laminarize/Chistmas-TrESP32/hardware/board_3d_render.png

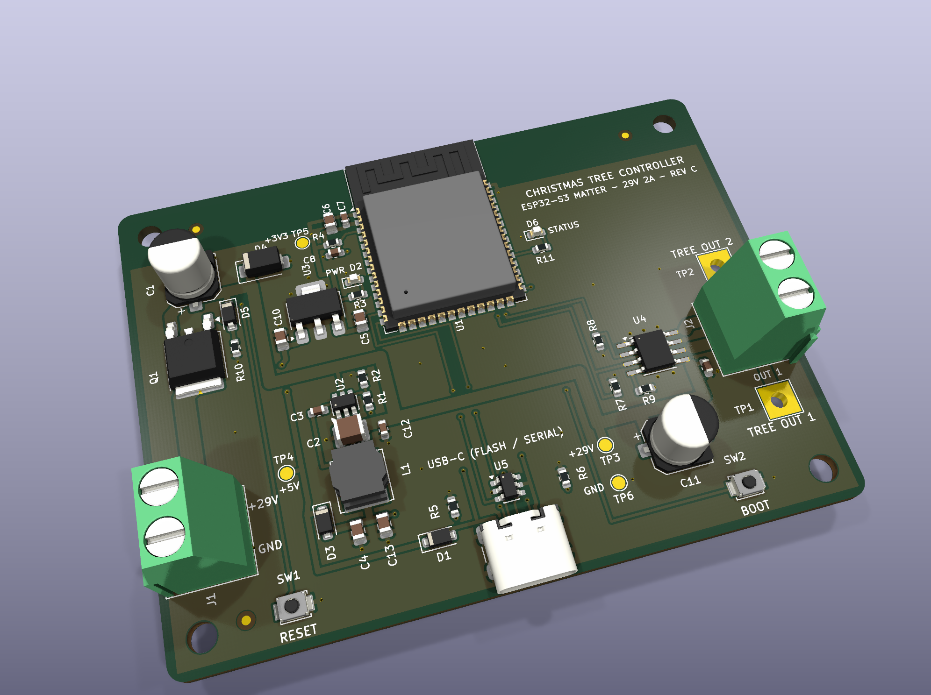
hardware/board_3d_render.png
