laminarize/Chistmas-TrESP32/README.md

# Christmas TrESP32 — SmartThings Matter Christmas Tree Controller

**Manufacturer:** `Pixel Paw Studio`  
**Model:** `Christmas TrESP32`

A high-performance DIY replacement for the stock 29V DC power supply and inline foot-pedal receiver controller (e.g., **Ting Shen `TS-48W29V`** `29V DC, 1.66A, 48W` brick + **`FPTSR-053-29-20`** inline button receiver + **Polygroup `PDT-015-14`** RF remote on the Home Decorators Collection `25PG90091` 9 ft. Yorkshire Twinkling Fir and similar 2-wire bi-color trees).

Built using **ESP-IDF** and the official **`esp-matter`** SDK on an **ESP32-S3**, this controller pairs natively with **Samsung SmartThings** over local Wi-Fi via **Matter** on **1 single endpoint** and includes a **custom local SmartThings Lua Edge Driver ([`edge-driver/`](edge-driver/))** that places **Master Power**, **Ultrasonic Dimmer (`25 kHz` PWM)**, and a clean **RGB Multicolor On/Off Toggle Switch** onto **1 single SmartThings app entry** (with zero rainbow color wheels or extra room tiles).

---

## 1. Hardware Options: Custom Rev C PCB vs. Breakout Modules

You can build this controller either using our **turnkey single-board custom PCB (`hardware/`, Rev C)** or on a breadboard/enclosure using off-the-shelf breakout modules.

### Option 1: Custom Single-Board Controller PCB (`hardware/`, Rev C — Recommended)

The [`hardware/`](hardware/) directory contains a complete KiCad 9/10 hardware design and ready-to-order **JLCPCB** and **PCBWay** fabrication + turnkey PCBA files (`80 × 60 mm`, 2-layer, `1 oz` copper, minimum drill `0.30 mm`):

- **Integrated Single-Plug Power & Logic:** Steps down the `29V DC` tree power brick via a TI **`LMR51430XDDCR`** (`36V, 3A` synchronous buck $\to 5.21\text{ V}$) and low-dropout `3.3V, 1A` regulator (`U3`: `AP7361C-33E-13` / `MCP1826S-3302E/DB`) to power an onboard **`ESP32-S3-WROOM-1-N8`** (`U1`) and TI **`DRV8871DDA`** H-bridge (`U4`, `R9 = 36 kΩ` $\to 1.78\text{ A}$ current limit, solid-poured thermal pad with tented vias).
- **Full Input & Host Computer USB Protection:**
  - **Zero-Drop Reverse-Polarity & Surge Protection:** **`AOD4185`** `40V` P-MOSFET (`Q1`) + `12V` gate Zener (`D5`) + **`SMAJ30A`** TVS clamp (`D4`), paired with the `29V 2A` Class 2 power supply's built-in hiccup OCP and `DRV8871`'s `1.78A` active cycle-by-cycle current limit.
  - **Computer-Safe Dual-Supply OR-ing (`D1`, `D3`) & USB ESD (`U5`):** Automotive-qualified (`AEC-Q101`) Nexperia **`PMEG4010CEH,115`** low-leakage `40V, 1A` MEGA Schottky diodes in flat-lead `SOD-123F` isolate `USB-C VBUS` (`J3`, protected by `USBLC6-2SC6`) from `+5V_BUCK` so plugging in a laptop while `29V DC` is live can never back-feed `VBUS`.
- **Flexible Tree Wiring & Onboard Diagnostics:**
  - **`J1` (`29V_DC_IN`):** `5.08 mm` Phoenix Contact (`1729128`) screw terminal for the `29V 2A` power brick.
  - **`J2` (`TREE_29V_OUT`) + `TP1`/`TP2`:** Connect the 2-wire tree cable either via the `5.08 mm` screw terminal (`J2`) or directly to the `4 × 4 mm` (`2.0 mm` plated hole) strain-relief solder pads (`TP1`/`TP2`).
  - **Onboard Controls, LEDs & Probe Pads:** `SW1` (`RESET`), `SW2` (`BOOT` / `GPIO 0`), `D2` (`3.3V` red power LED), `D6` (`GPIO 38` green Matter status LED), and `1.5 mm` SMD diagnostic probe pads `TP3` (`+29V`), `TP4` (`+5V`), `TP5` (`+3V3`), and `TP6` (`GND`).
- **Ordering Files (`hardware/`):**
  - **Bare PCB Fabrication (JLCPCB or PCBWay):** Upload [`hardware/gerbers.zip`](hardware/gerbers.zip).
  - **JLCPCB Turnkey PCBA:** Upload [`hardware/jlcpcb_bom.csv`](hardware/jlcpcb_bom.csv) (`42` populated parts across `28` verified in-stock LCSC `Cxxxxxx` lines, with `11` Basic/Preferred lines for free feeder setup) and [`hardware/jlcpcb_positions.csv`](hardware/jlcpcb_positions.csv) (`42` CPL placements with EasyEDA pad/polarity rotation & midpoint offsets).
  - **PCBWay Turnkey PCBA:** Upload [`hardware/bom.csv`](hardware/bom.csv) (`42` populated parts across `29` unique MPN lines) and [`hardware/positions.csv`](hardware/positions.csv) (`42` native KiCad IPC-7351B placements).

| Custom Rev C PCB Signal | ESP32-S3 Pin | Connected Hardware |
| :--- | :--- | :--- |
| **`TREE_IN1` (Warm White PWM)** | `GPIO 5` (`U1` Pin 5) | `DRV8871DDA` `IN1` (`25 kHz` PWM + `100 kΩ` pull-down `R7`) |
| **`TREE_IN2` (RGB Multicolor PWM)** | `GPIO 6` (`U1` Pin 6) | `DRV8871DDA` `IN2` (`25 kHz` PWM + `100 kΩ` pull-down `R8`) |
| **`BOOT` / Factory Reset Button** | `GPIO 0` (`U1` Pin 27) | `SW2` (`3 s` hold triggers Matter factory reset) |
| **`STATUS` LED (Matter State)** | `GPIO 38` (`U1` Pin 31) | `R11` (`1 kΩ`) + `D6` (`570 nm` green `0603` LED) |
| **Native USB-C Flash / Logs** | `GPIO 19` (`D-`), `GPIO 20` (`D+`) | `J3` (`USB4105-GF-A`) via `U5` (`USBLC6-2SC6`) |

---

### Option 2: Off-the-Shelf Breakout Bill of Materials (BOM)

| Component | Recommendation | Estimated Cost | Notes |
| :--- | :--- | :--- | :--- |
| **Microcontroller** | **ESP32-S3 DevKit** (8MB or 16MB Flash) | $5 – $9 | Dual-core Xtensa LX7, 2.4 GHz Wi-Fi + BLE 5.0 for Matter commissioning. |
| **H-Bridge Driver** | **Adafruit / TI DRV8871 Breakout Board** | $3 – $8 | Rated 6.5V – 45V DC @ 3.6A peak. Includes `POWER (+/-)` and `MOTOR` screw terminals plus `GND`, `VM`, `IN1`, `IN2` logic pins. Driven at `25 kHz` ultrasonic PWM for silent dimming. |
| **Power Supply (Tree LEDs)** | **Generic 29V 2A DC Power Supply** (Amazon) | $12 – $18 | Standard 29V DC / 2A (58W) replacement power brick for 29V LED Christmas trees. |
| **ESP32 Power** | **USB-C 5V Adapter** *or* **LM2596HV Buck Converter** | $0 – $4 | Power the ESP32-S3 directly via USB-C, or step down the 29V supply to 5.0V DC using an `LM2596HV` buck converter into `5V/VIN`. |

---

## 2. Electrical Wiring Diagram

Bypass the factory inline foot-pedal / RF receiver pod (e.g., **`FPTSR-053-29-20`**) downstream of the `29V` brick and connect the `DRV8871` output directly to the 2-wire tree string. The tree uses **anti-parallel LED strings** over its 2-wire bus:
- **Polarity A (`+29V` on `OUT1`, `GND` on `OUT2` — driven by `IN1` / `GPIO 5`):** Illuminates the **Warm White** LEDs (with built-in hardware twinkling on the secondary fairy bulbs).
- **Polarity B (`GND` on `OUT1`, `+29V` on `OUT2` — driven by `IN2` / `GPIO 6`):** Illuminates the **RGB Festive Multicolor** LEDs (with built-in hardware twinkling on the secondary fairy bulbs).
- **Motor Screw Terminal Polarity:** Because 2-wire bi-color trees wire Warm White and RGB LEDs in anti-parallel across the two wires, the `MOTOR` screw terminals are **non-polarized** with respect to safety—swapping the two tree wires simply swaps which polarity corresponds to Warm White vs. RGB Multicolor. *(Always bypass any inline factory foot-pedal/RF button pod first; leaving an inline receiver pod in series blocks reverse polarity.)*

### Option A: Powering ESP32-S3 via USB-C (Recommended & Simplest)

```
                      [ 120V AC Wall Plug ]
                                │
                                ▼
                     ┌─────────────────────┐
                     │ Generic 29V 2A PSU  │
                     │ Output: 29V DC 2.0A │
                     └───────┬─────┬───────┘
                    +29V DC  │     │  -29V (GND)
                             ▼     ▼
                  ┌───────────────────────────┐
   [ 5V USB-C ]   │  DRV8871 Breakout Board   │
        │         │                           │
        ▼         │  Screw Terminals:         │
┌───────────────┐ │   POWER + <── +29V DC     │
│ ESP32-S3      │ │   POWER - <── -29V (GND)  │
│               │ │   MOTOR 1 ────────────────┼───> Tree Wire +
│  GPIO 5 (5~) ─┼─┼─> IN1                     │
│  GPIO 6 (6~) ─┼─┼─> IN2     MOTOR 2 ────────┼───> Tree Wire -
│  GND ─────────┼─┼─> GND                     │
└───────────────┘ │  (VM pin is internally    │
                  │   tied to POWER +)        │
                  └───────────────────────────┘
```

### Option B: Single-Plug Power via LM2596HV Buck Converter (29V $\to$ 5.0V)

```
                      [ 120V AC Wall Plug ]
                                │
                                ▼
                     ┌─────────────────────┐
                     │ Generic 29V 2A PSU  │
                     │ Output: 29V DC 2.0A │
                     └──────────┬──────────┘
                                │  +29V DC & GND
                 ┌──────────────┴──────────────┐
                 │                             │
                 ▼                             ▼
      ┌────────────────────┐        ┌──────────────────────────┐
      │ LM2596HV Buck      │        │ DRV8871 Breakout Board   │
      │ IN+:  +29V DC      │        │ POWER + (VM): +29V DC    │
      │ IN-:  GND (Common) │        │ POWER - / GND: Common GND│
      │ OUT+: +5.0V DC     │        │ IN1: <── ESP32 GPIO 5    │
      │ OUT-: GND (Common) │        │ IN2: <── ESP32 GPIO 6    │
      └──────────┬─────────┘        │ MOTOR 1 ──┐              │
                 │ +5.0V            │ MOTOR 2 ──┼─┐            │
                 ▼                  └───────────┼─┼────────────┘
      ┌────────────────────┐                    │ │
      │ ESP32-S3 DevKit    │                    │ │
      │ 5V / VIN <── (+5V) │                    │ │
      │ GND      <── (GND) │                    │ │
      │ GPIO 5 (5~) ──> IN1│                    │ │
      │ GPIO 6 (6~) ──> IN2│                    │ │
      └────────────────────┘                    ▼ ▼
                                     ┌──────────────────────┐
                                     │ Tree 2-Pin Connector │
                                     │ Wire + : MOTOR 1     │
                                     │ Wire - : MOTOR 2     │
                                     └──────────────────────┘
```

### Pin Summary Table

| DRV8871 Pin / Terminal | Connected To | Purpose |
| :--- | :--- | :--- |
| **`POWER +`** (Screw Terminal) | `29V 2A PSU` **`+29V`** | High-voltage motor/LED supply (`29V DC`) |
| **`POWER -`** (Screw Terminal) | `29V 2A PSU` **`-` (`GND`)** | High-voltage return ground (internally tied to `GND` pin) |
| **`GND`** (Through-Hole Pin) | **ESP32-S3 `GND`** | Common logic ground reference between ESP32 and DRV8871 |
| **`VM`** (Through-Hole Pin) | *Leave unconnected* | Internally connected to `POWER +` on the breakout board |
| **`IN1`** (Through-Hole Pin) | **ESP32-S3 `GPIO 5` (`5~`)** | `25 kHz` PWM input for **Warm White** (`Polarity A`) |
| **`IN2`** (Through-Hole Pin) | **ESP32-S3 `GPIO 6` (`6~`)** | `25 kHz` PWM input for **RGB Multicolor** (`Polarity B`) |
| **`MOTOR`** (Screw Terminals) | **Tree `+` and `-` Cable** | Switched `29V` H-bridge output to the tree LED strings |

> [!CAUTION]
> **If using an LM2596HV Buck Converter:** Connect the 29V power supply to the buck converter inputs (`IN+` and `IN-`) **before** connecting the ESP32. Measure `OUT+` and `OUT-` with a multimeter and adjust the trim pot to **5.0V DC** before wiring `OUT+` to the ESP32 `5V/VIN` pin.

---

## 3. Single-Entry SmartThings UI & Local Edge Driver (`edge-driver/`)

`Christmas TrESP32` exposes **only 1 Matter Endpoint (`Endpoint 1`)** on the ESP32-S3 and ships with a local Lua Edge Driver ([`edge-driver/`](edge-driver/)) that runs directly on your SmartThings Hub over LAN, presenting **1 single device entry** in the SmartThings app with two clean sections on the same card:

| Card Section (Single App Entry) | SmartThings UI Control | Endpoint 1 Matter Mapping | Behavior |
| :--- | :--- | :--- | :--- |
| **`main` (`Christmas TrESP32`)** | **Master Power Button + Dimmer Slider (`1% – 100%`)** | `OnOff` (`OnOff`) & `LevelControl` (`CurrentLevel`) | • **Power Button:** Turns the tree completely On or Off.<br>• **Dimmer Slider:** Smoothly dims the active polarity (`1 – 254`, reaching true `100%` unchopped DC at max) via silent `25 kHz` PWM, which also naturally scales the hardware fairy-bulb twinkle pace. |
| **`rgbMode` (`RGB Multicolor`)** | **Simple On / Off Toggle Switch** *(same screen, below Dimmer)* | `ColorControl` (`ColorTemperatureMireds`: `455` = OFF, `154` = ON) | • **Toggle OFF:** **Warm White** (`Polarity A` / `GPIO 5` / `IN1`).<br>• **Toggle ON:** **RGB Festive Multicolor** (`Polarity B` / `GPIO 6` / `IN2`). |
| **Routines & Settings (`⋮ -> Settings`)** | **Preferred Turn-On / Turn-Off Dim Levels (`0% – 100%`)** | `LevelControl` (`MoveToLevelWithOnOff` & `MoveToLevel` while OFF) | • **SmartThings Routines:** Supports both **Turn On + Dimmer %** and **Turn Off + pre-staged Dimmer %** (stages brightness without turning the tree back on).<br>• **Card Power-On / Power-Off Schedules:** Set **Preferred Turn-On Dim Level (%)** and/or **Preferred Dim Level on Turn-Off (%)** in `More (⋮) -> Settings`. |

### Installing the Local SmartThings Edge Driver to Your Hub (One-Time Setup)

Run the included helper script on macOS:
```bash
./deploy-edge-driver.sh
```
This installs Samsung's official `@smartthings/cli` via Homebrew (if not already installed), opens a one-time browser login to your Samsung account, creates/enrolls a local Edge channel on your SmartThings Hub if needed, and packages + installs [`edge-driver/`](edge-driver/) straight onto your Hub (`smartthings edge:drivers:package edge-driver -I`).

- **If `Christmas TrESP32` is already paired in SmartThings:** Open its card $\to$ **More (`⋮`) $\to$ Driver $\to$ Select a different driver** $\to$ choose **`Christmas TrESP32`**.
- **If pairing fresh:** Scan the Matter QR/manual code as usual—the Hub automatically matches `VendorId = 0xFFF1` / `ProductId = 0x8000` to **`Christmas TrESP32`**.

---

## 4. Contained Build & Flash Workflow

This project uses a self-contained build and flash workflow on macOS:
- **Build Environment (Docker):** Compiles inside the official `espressif/esp-matter` container (`ESP-IDF v6.0.2`).
- **Flashing & Serial Monitor (Local `.venv`):** Uses a lightweight Python virtual environment (`.venv`) with `esptool` and `pyserial` on the macOS host to communicate with `/dev/cu.usbmodem*`.

### Step 1: Build the Firmware in Docker
Ensure Docker Desktop is running, then run:
```bash
./build-docker.sh
```
This compiles `build/christmas_tree_matter.bin`, `build/bootloader/bootloader.bin`, and `build/partition_table/partition-table.bin`.

### Step 2: Flash to ESP32-S3
Plug the ESP32-S3 into your Mac via USB and run:
```bash
./flash.sh
```

Additional `./flash.sh` commands:
```bash
./flash.sh info       # Read ESP32-S3 chip info and MAC address
./flash.sh monitor    # Open 115200-baud serial monitor (Ctrl+] to exit)
./flash.sh erase      # Erase entire flash (clears NVS & Matter fabrics)
```

---

## 5. Pairing & Resetting with Samsung SmartThings

### Commissioning Steps
1. Open the serial monitor (`./flash.sh monitor`) and press the `RST` button on the ESP32-S3. On boot, the firmware prints a `SetupQRCode` URL and an 11-digit `Manual pairing code` to the serial console.
2. Open the **Samsung SmartThings** app on your phone (connected to your **2.4 GHz Wi-Fi** network with Bluetooth enabled).
3. Tap **"+"** $\to$ **Add device** $\to$ **Scan QR code** (or **Partner devices** $\to$ **Matter**).
4. Scan the generated QR code or enter the 11-digit manual pairing code displayed in your serial console.
5. If prompted about an **Uncertified Accessory**, tap **Add Anyway**.

### Resetting, Pairing & `STATUS` LED (`GPIO 38`) States
- **Onboard `STATUS` LED (`GPIO 38` / Rev C `D6`):**
  - **`1 Hz` Blink (`500 ms` ON / `500 ms` OFF):** Uncommissioned or Matter commissioning window open (ready to pair over BLE).
  - **`2.5 Hz` Blink (`200 ms` ON / `200 ms` OFF):** Matter `Identify` command active from SmartThings / Matter controller.
  - **`5 Hz` Rapid Blink (`100 ms` ON / `100 ms` OFF):** `BOOT` button (`GPIO 0`) is currently held down during the 3-second factory-reset countdown.
  - **Solid ON:** Commissioned onto a Matter fabric and operating normally.
- **Automatic Reset on Delete:** Whenever you delete the device from the SmartThings app while it is online, the firmware intercepts `DeviceEventType::kFabricRemoved` and automatically runs `esp_matter::factory_reset()`, wiping all fabrics and immediately restarting BLE pairing advertisements.
- **Physical `BOOT` Button Reset (3-Second Hold):** Hold down the **`BOOT`** button (`GPIO 0` / `SW2`) on the ESP32-S3 for **3 seconds** at any time to trigger a Matter factory reset and reopen BLE pairing mode without needing a computer.
- **USB Erase:** Run `./flash.sh erase && ./flash.sh flash` over USB.

> [!TIP]
> **iPhone / iOS Re-Pairing Tip (Error `39-900`):**
> When pairing via an iPhone, iOS first commissions the device into the Apple Home / iOS Matter Keychain before handing it off to the SmartThings Hub. If you delete the device and re-pair later, check **iPhone Settings $\to$ General $\to$ Matter Accessories** and remove any leftover entry for the device first so iOS does not attempt to reuse a deleted fabric. Also ensure your iPhone, SmartThings Hub, and ESP32 are on the same 2.4 GHz Wi-Fi subnet with local network access enabled for SmartThings.
