laminarize/Chistmas-TrESP32/hardware/schematic.pdf

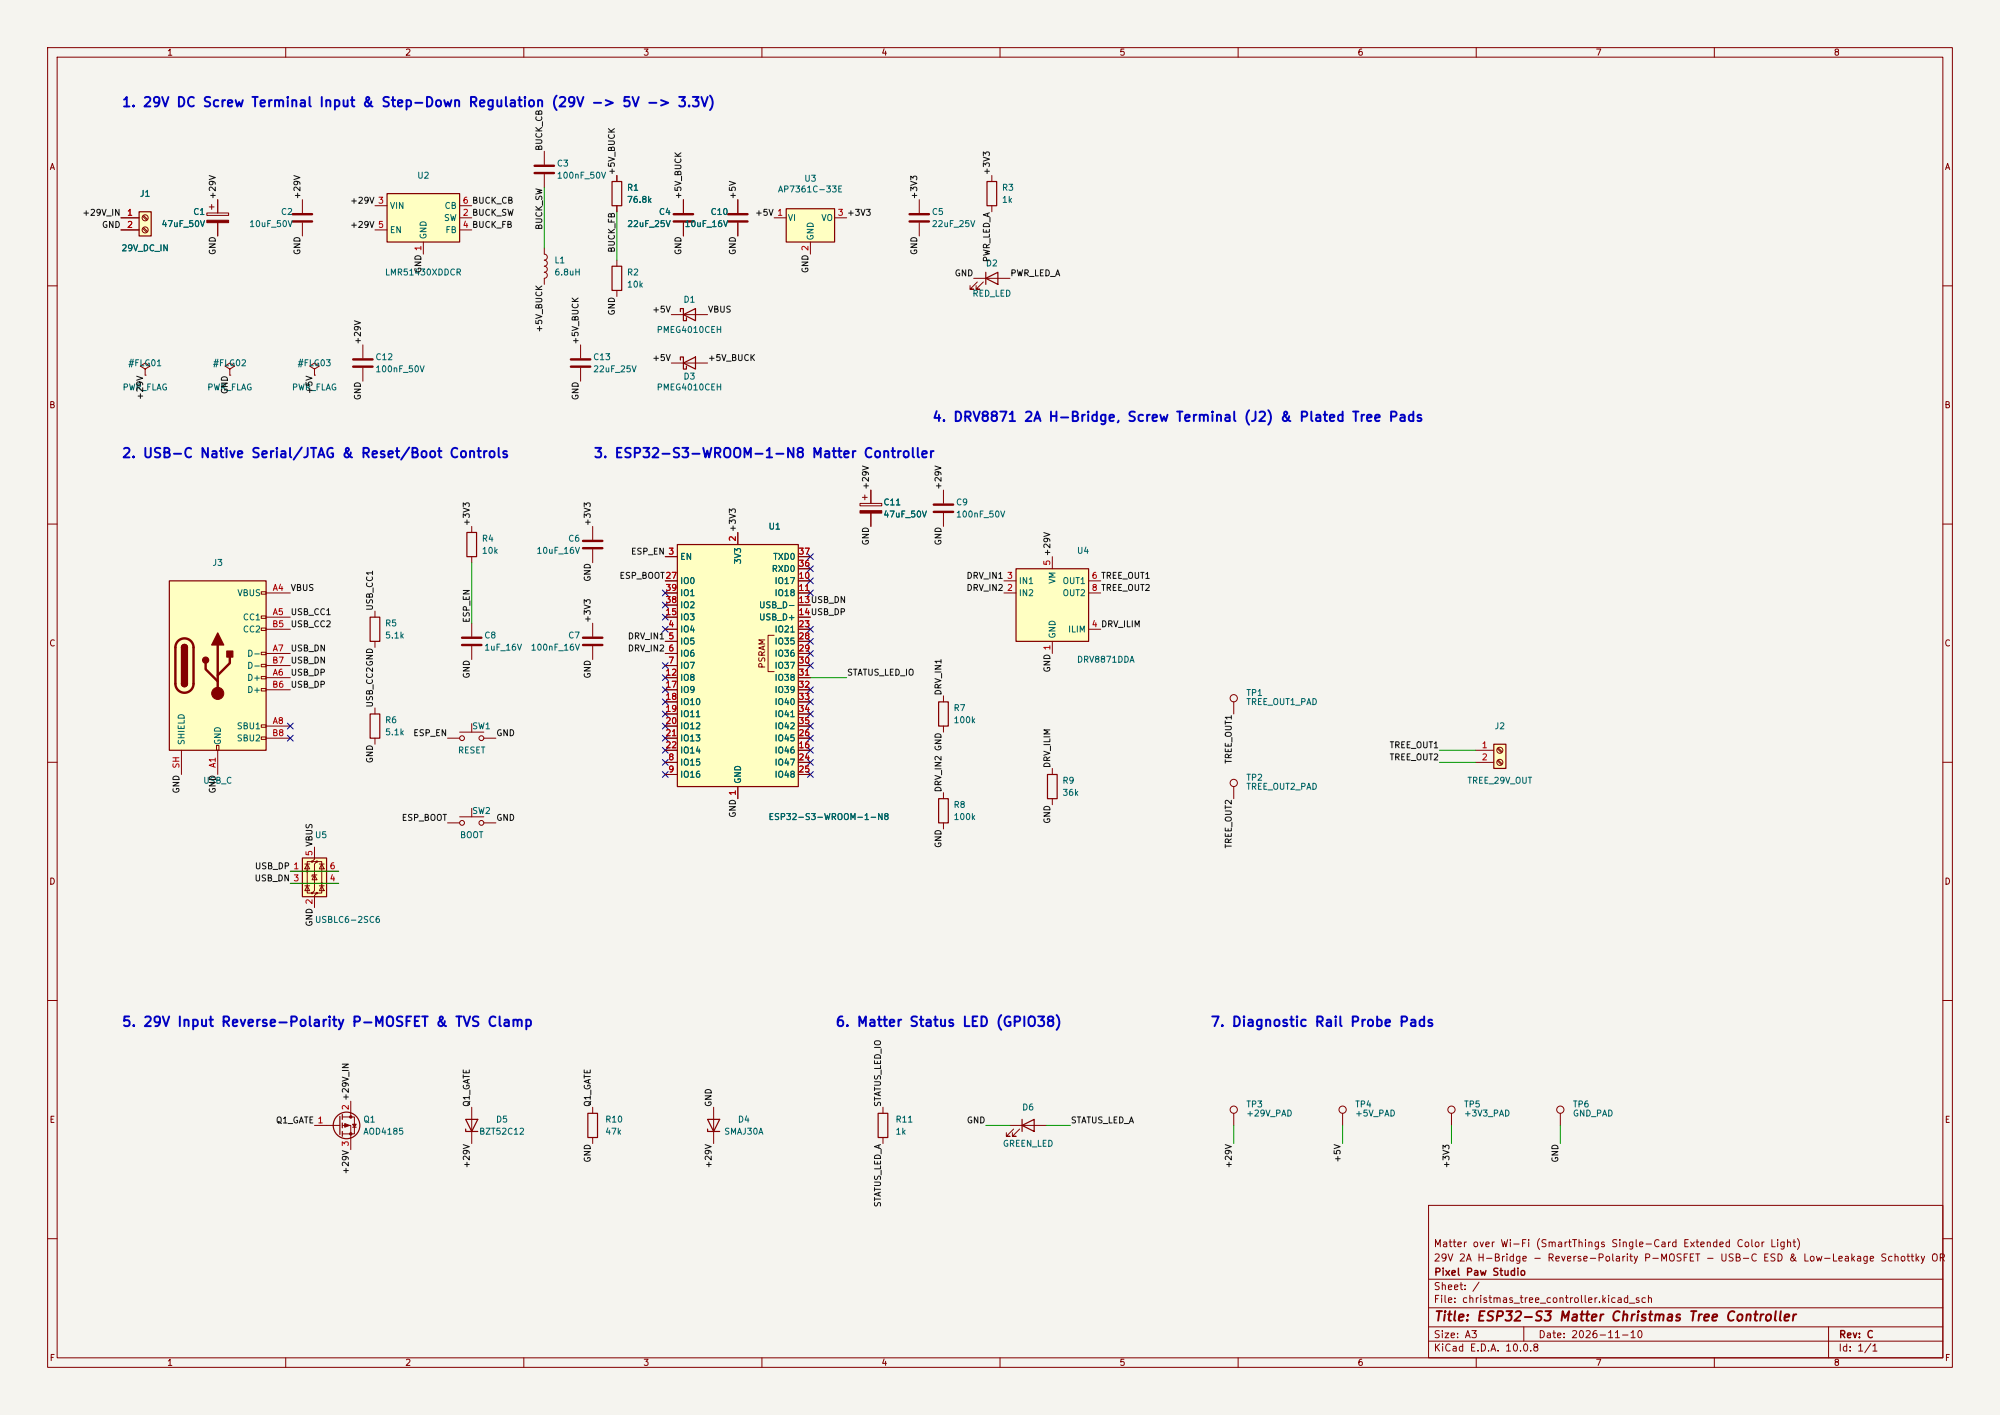
[picture p2: page 1]

1. 29V DC Screw Terminal Input & Step-Down Regulation (29V -> 5V -> 3.3V)

4. DRV8871 2A H-Bridge, Screw Terminal (J2) & Plated Tree Pads
TREE_OUT2 DRV_ILIM GND

7. Diagnostic Rail Probe Pads

Matter over Wi-Fi (SmartThings Single-Card Extended Color Light)
29V 2A H-Bridge - Reverse-Polarity P-MOSFET - USB-C ESD & Low-Leakage Schottky OR
Pixel Paw Studio
Sheet: /
File: christmas_tree_controller.kicad_sch
Title: ESP32-S3 Matter Christmas Tree Controller

Size: A3 | Rev: C | F Date: 2026-11-10
KiCad E.D.A. 10.0.8 | Id: 1/1
