laminarize/Chistmas-TrESP32/hardware/christmas_tree_controller.kicad_pcb

## KiCad design hardware/christmas_tree_controller.kicad_pcb (2026-11-11)

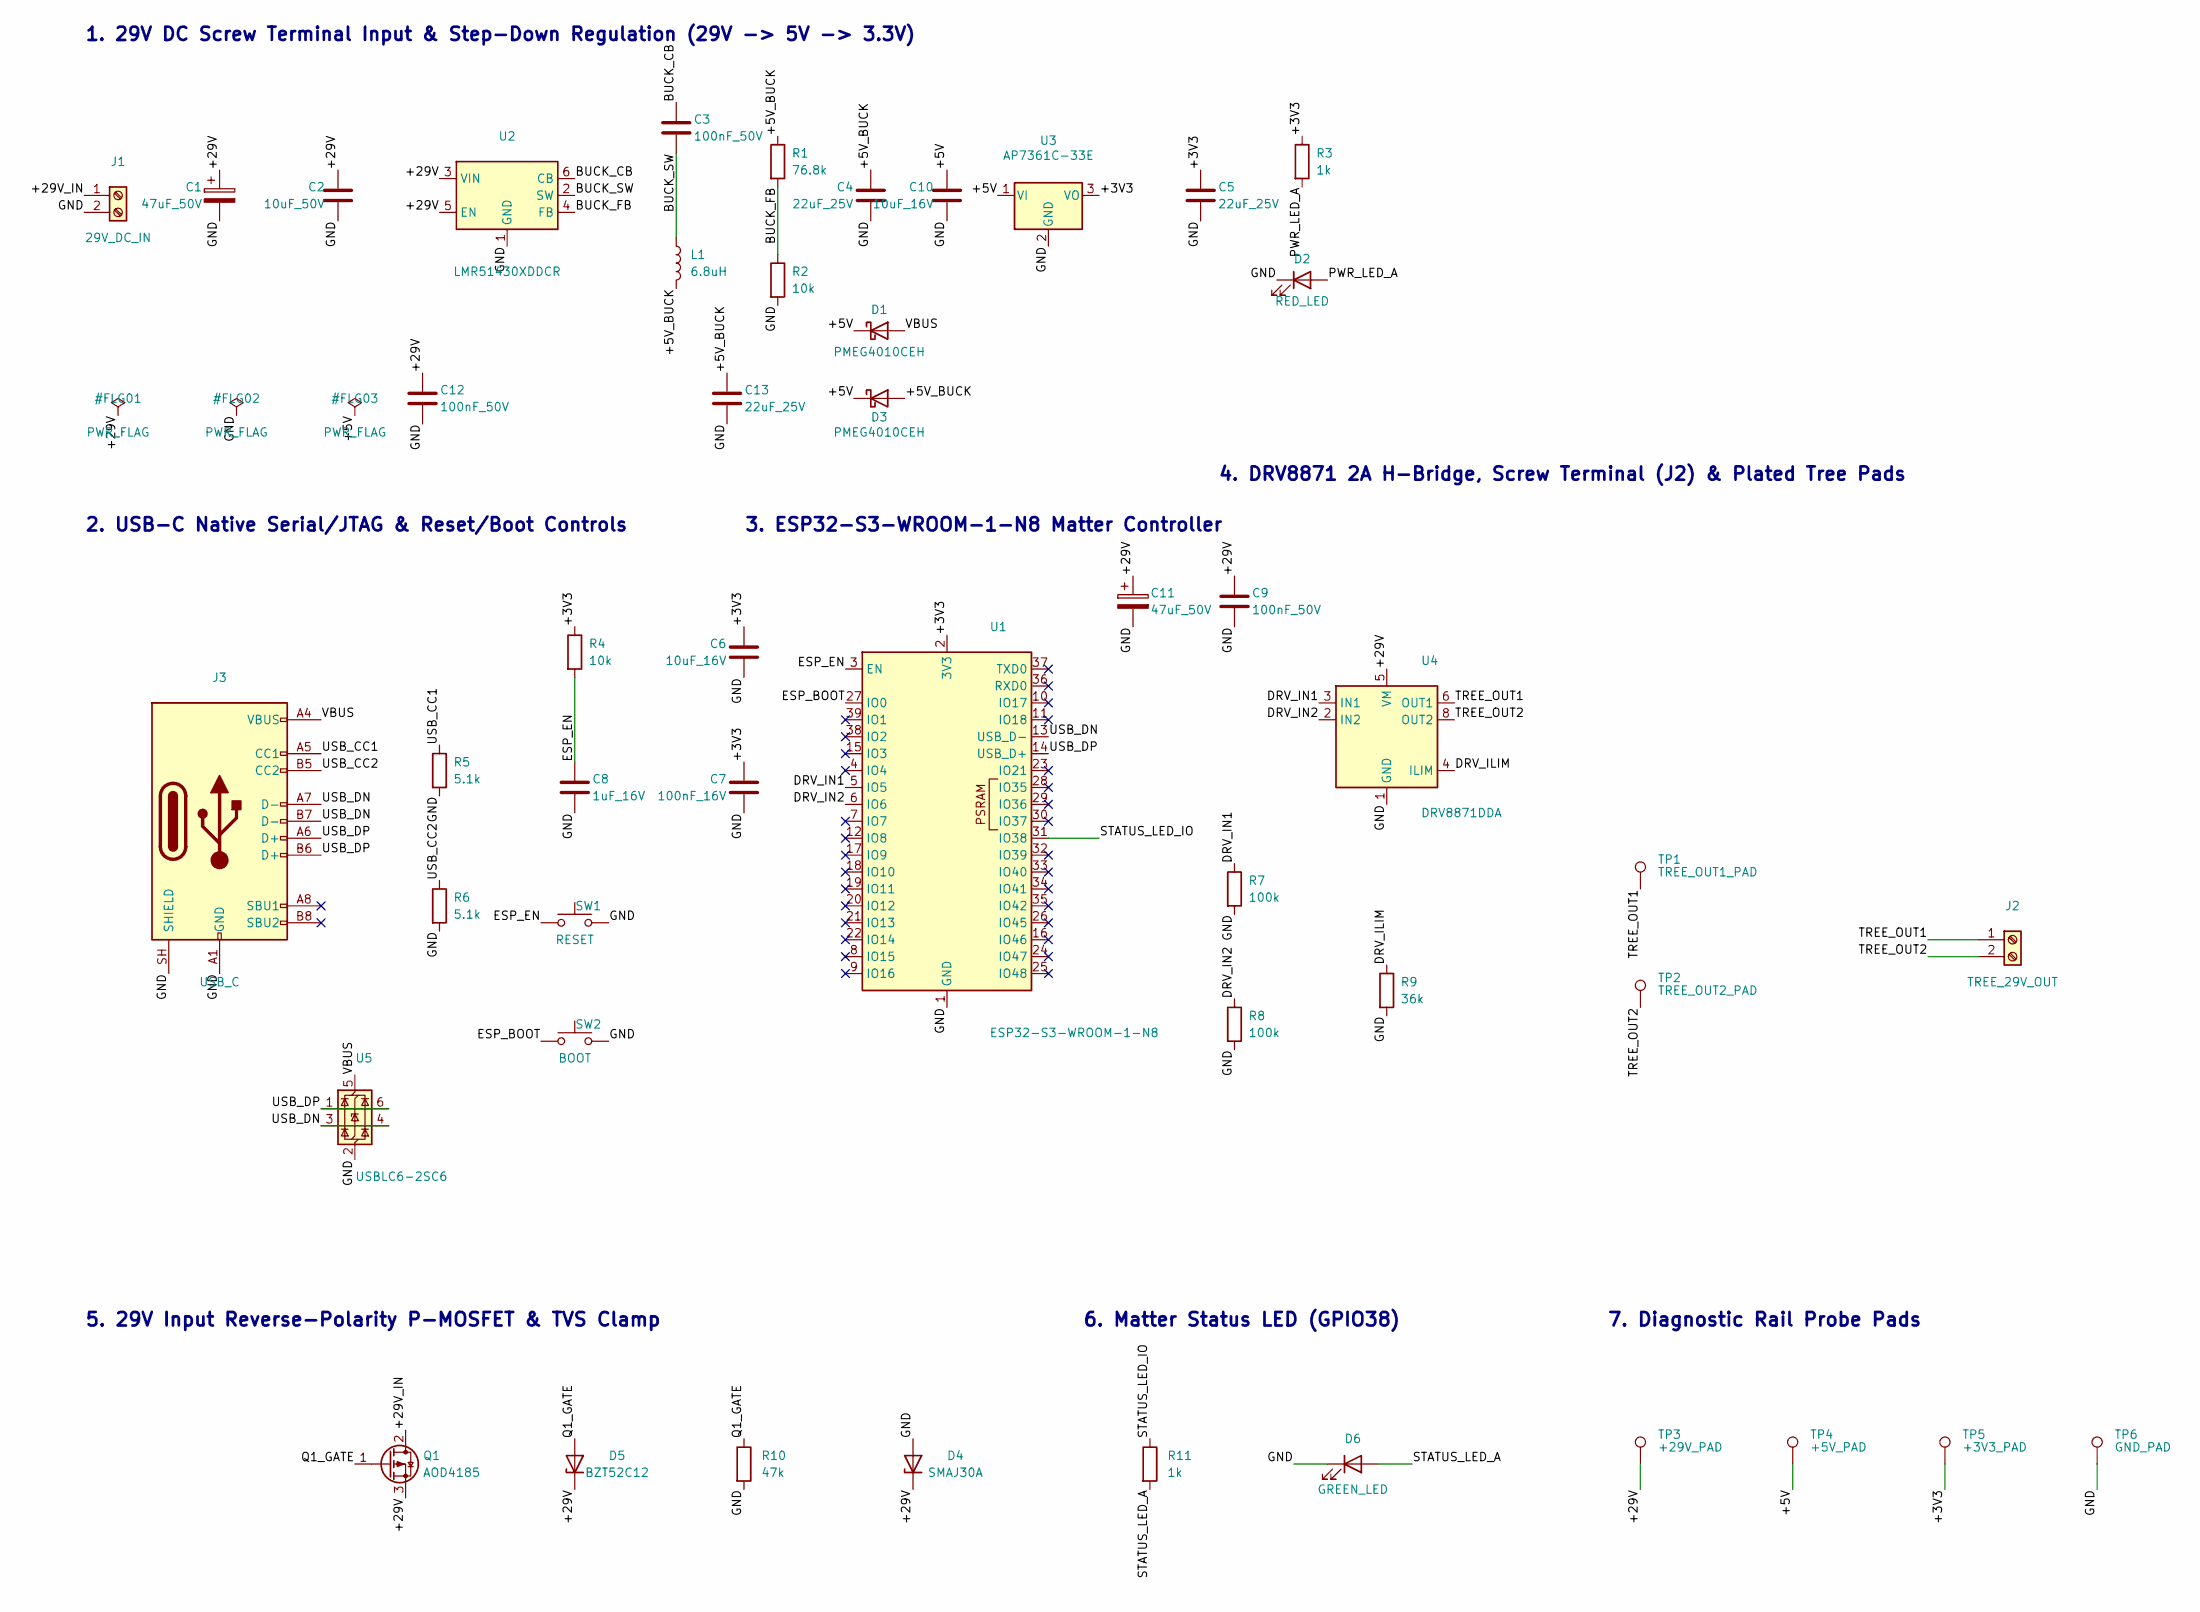
[picture p3: schematic christmas_tree_controller.kicad_sch, ESP32-S3 Matter Christmas Tree Controller]

Parts:
C1, C11: 47uF_50V; CP_Elec_6.3x7.7; MPN EEE-FK1H470P
C2: 10uF_50V; C_1210_3225Metric; MPN GRM32ER71H106KA12L
C3, C9, C12: 100nF_50V; C_0603_1608Metric; MPN CC0603KRX7R9BB104
C4, C5, C13: 22uF_25V; C_0805_2012Metric; MPN CL21A226MAQNNNE
C6, C10: 10uF_16V; C_0805_2012Metric; MPN CL21B106KOQNNNE
C7: 100nF_16V; C_0603_1608Metric; MPN CC0603KRX7R7BB104
C8: 1uF_16V; C_0603_1608Metric; MPN CL10B105KO8NNNC
D1, D3: PMEG4010CEH; D_SOD-123F; MPN PMEG4010CEH,115
D2: RED_LED; LED_0603_1608Metric; MPN 150060RS75000
D4: SMAJ30A; D_SMA; MPN SMAJ30A
D5: BZT52C12; D_SOD-123; MPN BZT52C12-7-F
D6: GREEN_LED; LED_0603_1608Metric; MPN 150060VS75000
J1: 29V_DC_IN; TerminalBlock_Phoenix_MKDS-1,5-2-5.08_1x02_P5.08mm_Horizont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; MPN 1729128
J2: TREE_29V_OUT; TerminalBlock_Phoenix_MKDS-1,5-2-5.08_1x02_P5.08mm_Horizont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; MPN 1729128
J3: USB_C; USB_C_Receptacle_GCT_USB4105-xx-A_16P_TopMnt_Horizontal; MPN USB4105-GF-A
L1: 6.8uH; L_Bourns_SRN6045TA; MPN SRN6045TA-6R8M
Q1: AOD4185; TO-252-2; MPN AOD4185
R1: 76.8k; R_0603_1608Metric; MPN RC0603FR-0776K8L
R2, R4: 10k; R_0603_1608Metric; MPN RC0603FR-0710KL
R3, R11: 1k; R_0603_1608Metric; MPN RC0603FR-071KL
R5, R6: 5.1k; R_0603_1608Metric; MPN RC0603FR-075K1L
R7, R8: 100k; R_0603_1608Metric; MPN RC0603FR-07100KL
R9: 36k; R_0603_1608Metric; MPN RC0603FR-0736KL
R10: 47k; R_0603_1608Metric; MPN RC0603FR-0747KL
SW1: RESET; SW_SPST_B3U-1000P-B; MPN B3U-1000P-B
SW2: BOOT; SW_SPST_B3U-1000P-B; MPN B3U-1000P-B
TP1: TREE_OUT1_PAD; TestPoint_THTPad_4.0x4.0mm_Drill2.0mm
TP2: TREE_OUT2_PAD; TestPoint_THTPad_4.0x4.0mm_Drill2.0mm
TP3: +29V_PAD; TestPoint_Pad_D1.5mm
TP4: +5V_PAD; TestPoint_Pad_D1.5mm
TP5: +3V3_PAD; TestPoint_Pad_D1.5mm
TP6: GND_PAD; TestPoint_Pad_D1.5mm
U1: ESP32-S3-WROOM-1-N8; ESP32-S3-WROOM-1_0.3mmVias; MPN ESP32-S3-WROOM-1-N8
U2: LMR51430XDDCR; SOT-23-6; MPN LMR51430XDDCR
U3: AP7361C-33E; SOT-223-3_TabPin2; MPN AP7361C-33E-13
U4: DRV8871DDA; DRV8871DDA_HTSOP-8-1EP_TentedWindowed; MPN DRV8871DDAR
U5: USBLC6-2SC6; SOT-23-6; MPN USBLC6-2SC6

Connections:
/+3V3: C5.1, C6.1, C7.1, R3.1, R4.1, TP5.1, U1.2 (3V3), U3.3 (VO)
/+5V: C10.1, D1.1 (K), D3.1 (K), TP4.1, U3.1 (VI)
/+5V_BUCK: C4.1, C13.1, D3.2 (A), L1.2, R1.1
/+29V: C1.1, C2.1, C9.1, C11.1, C12.1, D4.1 (K), D5.1 (K), Q1.3 (S), TP3.1, U2.3 (VIN), U2.5 (EN), U4.5 (VM)
/+29V_IN: J1.1, Q1.2 (D)
/BUCK_CB: C3.1, U2.6 (CB)
/BUCK_FB: R1.2, R2.1, U2.4 (FB)
/BUCK_SW: C3.2, L1.1, U2.2 (SW)
/DRV_ILIM: R9.1, U4.4 (ILIM)
/DRV_IN1: R7.1, U1.5 (IO5), U4.3 (IN1)
/DRV_IN2: R8.1, U1.6 (IO6), U4.2 (IN2)
/ESP_BOOT: SW2.1, U1.27 (IO0)
/ESP_EN: C8.1, R4.2, SW1.1, U1.3 (EN)
/GND: C1.2, C2.2, C4.2, C5.2, C6.2, C7.2, C8.2, C9.2, C10.2, C11.2, C12.2, C13.2, D2.1 (K), D4.2 (A), D6.1 (K), J1.2, J3.A1 (GND), J3.A12 (GND), J3.B1 (GND), J3.B12 (GND), J3.SH (SHIELD), R2.2, R5.2, R6.2, R7.2, R8.2, R9.2, R10.2, SW1.2, SW2.2, TP6.1, U1.1 (GND), U1.40 (GND), U1.41 (GND), U2.1 (GND), U3.2 (GND), U4.1 (GND), U4.7 (GND), U4.9 (GND), U5.2 (GND)
/PWR_LED_A: D2.2 (A), R3.2
/Q1_GATE: D5.2 (A), Q1.1 (G), R10.1
/STATUS_LED_A: D6.2 (A), R11.2
/STATUS_LED_IO: R11.1, U1.31 (IO38)
/TREE_OUT1: J2.1, TP1.1, U4.6 (OUT1)
/TREE_OUT2: J2.2, TP2.1, U4.8 (OUT2)
/USB_CC1: J3.A5 (CC1), R5.1
/USB_CC2: J3.B5 (CC2), R6.1
/USB_DN: J3.A7 (D-), J3.B7 (D-), U1.13 (USB_D-), U5.3 (I/O2), U5.4 (I/O2)
/USB_DP: J3.A6 (D+), J3.B6 (D+), U1.14 (USB_D+), U5.1 (I/O1), U5.6 (I/O1)
/VBUS: D1.2 (A), J3.A4 (VBUS), J3.A9 (VBUS), J3.B4 (VBUS), J3.B9 (VBUS), U5.5 (VBUS)

Notes on the sheet:
1. 29V DC Screw Terminal Input & Step-Down Regulation (29V -> 5V -> 3.3V)
2. USB-C Native Serial/JTAG & Reset/Boot Controls
3. ESP32-S3-WROOM-1-N8 Matter Controller
4. DRV8871 2A H-Bridge, Screw Terminal (J2) & Plated Tree Pads
5. 29V Input Reverse-Polarity P-MOSFET & TVS Clamp
6. Matter Status LED (GPIO38)
7. Diagnostic Rail Probe Pads

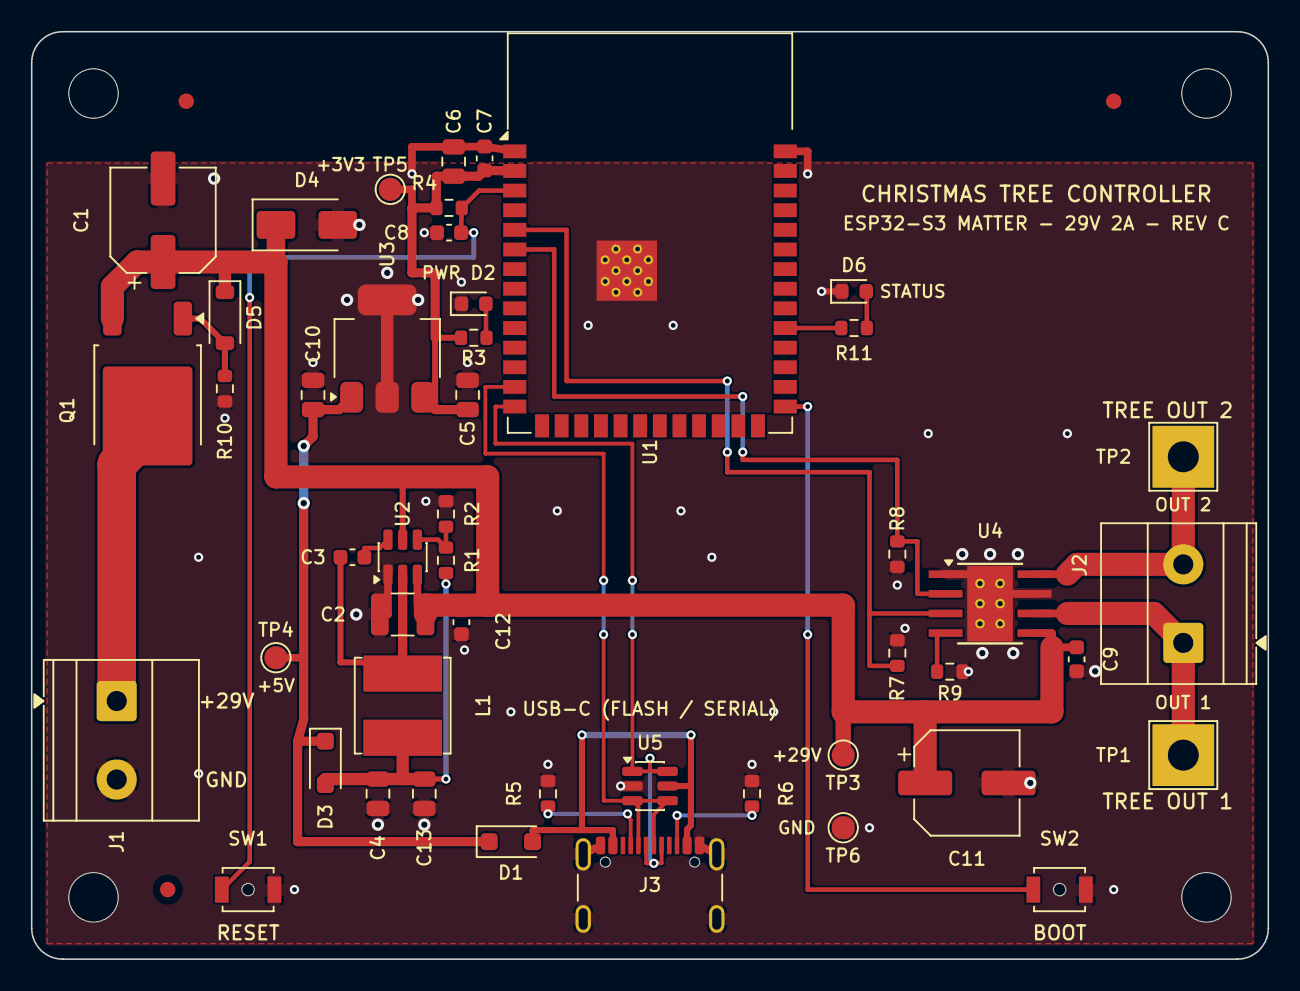
[picture p4: board christmas_tree_controller.kicad_pcb from above]

Board: 2 copper layers, 80.0 x 60.0 mm, 55 parts (0 on the bottom side), 25 nets.

Other parts of the board:
FID1, FID2, FID3: Fiducial_1mm_Mask2mm
MH1, MH2, MH3, MH4: MountingHole_3.2mm_M3
