laminarize/Chistmas-TrESP32/(commit log)

2026-11-09 Initial implementation of Christmas TrESP32 Matter controller for 2-pin Christmas trees
    [partitions.csv]
2026-11-11 Add Rev C custom PCB hardware, JLCPCB/PCBWay PCBA exports, and GPIO 38 Matter status LED
    [bom.csv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]
2026-11-11 Switch twinkle to 30% square wave, fix 100% LEDC DC duty, and guard Polarity A
    [matter_node.cpp, tree_driver.c, tree_driver.h, tree_effects.c]
2026-11-14 Add single-card SmartThings Edge driver, re-enable Polarity B RGB, and support Routine/preferred dim levels
